davidectnia/InterleavedBoost-LIGH2TDRONE/IMAGES/immagini/plots/mccm_proto.png

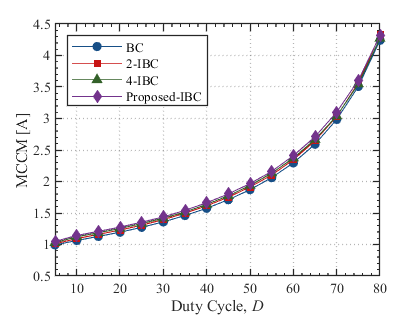
IMAGES/immagini/plots/mccm_proto.png
