davidectnia/InterleavedBoost-LIGH2TDRONE/SPICE/GateDriver/GateDriver_test.asc

C1: cap; 1µ
C2: cap; 1µ
R1: res; 22
R2: res; 20
U1: IR2110
U2: ST8L65N050DM9_V2K
V1: voltage; 3.3
V2: voltage; PULSE(0 3.3 0 10n 10n {D*Ts} {Ts})
V3: voltage; 12
V4: voltage; 44
Named nets: 0, Drain, Common, Gate, PWM
.lib ST8L65N050DM9_V2K.LIB
.temp 26.85
.tran 1m
.param D 0.73
.param fs 400k
.param Ts 1/fs
