davidectnia/InterleavedBoost-LIGH2TDRONE/SPICE/H100/test.asc

B1: bv; V=a*(-I(B1))**3+b*(-I(B1))**2+c*(-I(B1))+d
C1: cap; 100µ
R1: res; 1.5
Named nets: 0, +, -
.param a=-0.0026 b=0.3404 c=-1.87 dd=18.03
