davidectnia/InterleavedBoost-LIGH2TDRONE/SPICE/H100/test2.asc

B1: bv; V=a*(-I(B1))**3+b*(-I(B1))**2+c*(-I(B1))+d
B2: bv; V=a*(-I(B1))**3+b*(-I(B1))**2+c*(-I(B1))+d
B3: bv; V=a*(-I(B1))**3+b*(-I(B1))**2+c*(-I(B1))+d
C1: cap; 100µ
C2: cap; 1n
I1: current; 1
I2: current; 1
I3: current; 1
R1: res; 1.5
R2: res; 1.5
R3: res; 100m
Named nets: 0
.param a=-0.026 b=0.3404 c=-1.87 d=18.03
.dc I1 0 10 0.01
