davidectnia/InterleavedBoost-LIGH2TDRONE/SPICE/Capacitor Stack/capacitor_stack_input50V.asc

C1: cap; {C_CER1u}; Rser={ESR_CER1u} Lser={ESL_CER1u}
C2: cap; {C_CER220n}; Rser={ESR_CER220n} Lser={ESL_CER220n}
C3: cap; {C_CER1u}; Rser={ESR_CER1u} Lser={ESL_CER1u}
C4: cap; {C_CER220n}; Rser={ESR_CER220n} Lser={ESL_CER220n}
C5: cap; {C_CER10u}; Rser={ESR_CER10u} Lser={ESL_CER10u}
C6: cap; {C_CER10n}; Rser={ESR_CER10n} Lser={ESL_CER10n}
C7: cap; {C_CER100n}; Rser={ESR_CER100n} Lser={ESL_CER100n}
C8: cap; {C_CER1u}; Rser={ESR_CER1u} Lser={ESL_CER1u}
C9: cap; {C_CER10u}; Rser={ESR_CER10u} Lser={ESL_CER10u}
C10: cap; {C_CER220n}; Rser={ESR_CER220n} Lser={ESL_CER220n}
C11: cap; {C_CER2u2}; Rser={ESR_CER2u2} Lser={ESL_CER2u2}
C12: cap; {C_CER10u}; Rser={ESR_CER10u} Lser={ESL_CER10u}
C13: cap; {C_CER4u7}; Rser={ESR_CER4u7} Lser={ESL_CER4u7}
I1: current; ""; AC 1
I2: current; ""; AC 1
I3: current; ""; AC 1
I4: current; ""; AC 1
I5: current; ""; AC 1
I6: current; ""; AC 1
I7: current; ""; AC 1
Named nets: 0, 10n, 1u, 220N, 100N, 10u
.ac dec 100 100k 100Meg
.param C_CER1u 1u
.param ESR_CER1u 6.2m
.param ESL_CER1u 470p
.param C_CER100n 100n
.param ESR_CER100n 25m
.param ESL_CER100n 3n
.param C_CER220n 220n
.param ESR_CER220n 25m
.param ESL_CER220n 3n
.param C_CER10n 10n
.param ESR_CER10n 6.5m
.param ESL_CER10n 11.2n
.param C_CER10u 10u
.param ESR_CER10u 3m
.param ESL_CER10u 1n
.param C_CER2u2 2.2u
.param ESR_CER2u2 3m
.param ESL_CER2u2 1n
.param C_CER4u7 4.7u
.param ESR_CER4u7 3m
.param ESL_CER4u7 1n
