davidectnia/InterleavedBoost-LIGH2TDRONE/SPICE/Capacitor Stack/capacitor_stack_output100V.asc

C1: cap; {C_CER1}; Rser={ESR_CER1} Lser={ESL_CER1}
C2: cap; {C_CER2}; Rser={ESR_CER2} Lser={ESL_CER2}
C3: cap; {C_CER_470n}; Rser={ESR_CER2} Lser={ESL_CER2}
C4: cap; {C_EL}; Rser={ESR_C_EL} Lser={ESL_C_EL}
C5: cap; {C_EL}; Rser={ESR_C_EL} Lser={ESL_C_EL}
C6: cap; {C_EL}; Rser={ESR_C_EL} Lser={ESL_C_EL}
C7: cap; {C_EL}; Rser={ESR_C_EL} Lser={ESL_C_EL}
C8: cap; {C_CER1}; Rser={ESR_CER1} Lser={ESL_CER1}
C9: cap; {C_CER3}; Rser={ESR_CER3} Lser={ESL_CER3}
C10: cap; {C_CER2}; Rser={ESR_CER2} Lser={ESL_CER2}
C11: cap; {C_EL_22u}; Rser={ESR_C_EL} Lser={ESL_C_EL}
C12: cap; {C_EL_22u}; Rser={ESR_C_EL} Lser={ESL_C_EL}
C13: cap; {C_CER_100n}; Rser={ESR_CER1} Lser={ESL_CER1}
C14: cap; {C_EL_22u}; Rser={ESR_C_EL} Lser={ESL_C_EL}
C15: cap; {C_CER_1u}; Rser={ESR_CER3} Lser={ESL_CER3}
C16: cap; {C_CER1}; Rser={ESR_CER1} Lser={ESL_CER1}
C17: cap; {C_EL}; Rser={ESR_C_EL} Lser={ESL_C_EL}
C18: cap; {C_CER1}; Rser={ESR_CER1} Lser={ESL_CER1}
C19: cap; {C_EL}; Rser={ESR_C_EL} Lser={ESL_C_EL}
C20: cap; {C_EL}; Rser={ESR_C_EL} Lser={ESL_C_EL}
C21: cap; {C_CER3}; Rser={ESR_CER3} Lser={ESL_CER3}
C22: cap; {C_CER3}; Rser={ESR_CER3} Lser={ESL_CER3}
C23: cap; {C_CER1}; Rser={ESR_CER1} Lser={ESL_CER1}
I1: current; 0; AC 1
I2: current; 0; AC 1
I3: current; 0; AC 1
I4: current; 0; AC 1
I5: current; 0; AC 1
I6: current; 0; AC 1
I7: current; 0; AC 1
Named nets: 0
.param C_EL 22u
.param ESR_C_EL 40m
.param ESL_C_EL 5n
.param C_CER1 100n
.param ESR_CER1 30m
.param ESL_CER1 500p
.param C_CER3 1u
.param ESR_CER3 12m
.param ESL_CER3 970p
.param C_CER2 470n
.param ESR_CER2 30m
.param ESL_CER2 550p
Ceramic Capacitors
Electrolythic Capacitors
.ac dec 100 100k 100Meg
