davidectnia/InterleavedBoost-LIGH2TDRONE/SPICE/Capacitor Stack/stack_cap_input.asc

C3: cap; {C_CER1}; Rser={ESR_CER1} Lser={ESL_CER1}
C5: cap; {C_CER3}; Rser={ESR_CER3} Lser={ESL_CER3}
Named nets: C+, C-
.param C_CER1 100n
.param ESR_CER1 22.1m
.param ESL_CER1 253.3p
.param C_CER3 1u
.param ESR_CER3 6.2m
.param ESL_CER3 54.5p
50V Voltage Rating Ceramic Capacitors
