davidectnia/InterleavedBoost-LIGH2TDRONE/SPICE/Elementary/boostideal.asc

C1: cap; {Cin}; Rser=10m
C2: cap; {Co}; Rser=200m
D1: diode; Ideal_D
L1: ind; {Ld}
R1: res; {RL}
S1: sw; Ideal_SW
V1: voltage; PULSE(0 10 0 10n 10n {D*Ts} {Ts})
V2: voltage; {V_in}; Rser=10m
Named nets: 0, out, in
.param Ld=27u
.param Co=47u
.param RL 20
.param Dmin 0.2105
.param Dmax 0.6053
.param Vin_min 150
.param Vin_max 300
.param fs 400k
.tran 0 {Tend} 0 10n
.param V_in=12
.param D=1-{V_in}/{Vout}
.param Cin  1u
.param Ts=1/fs Tstart={Tend}-Nperiods*Ts Tend=5m
.model Ideal_SW SW(Ron = 10m)
.model Ideal_D D(Ron = 1m, Vfwd=0)
.meas Id_avg AVG I(D1) FROM Tstart TO Tend
.meas Id_rms RMS I(D1) FROM Tstart TO Tend
.meas IL_avg AVG I(L1) FROM Tstart TO Tend
.meas IL_rms RMS I(L1) FROM Tstart TO Tend
.meas Isw_avg AVG I(S1) FROM Tstart TO Tend
.meas Isw_rms RMS I(S1) FROM Tstart TO Tend
.meas Ico_avg AVG I(C2) FROM Tstart TO Tend
.meas Ico_rms RMS I(C2) FROM Tstart TO Tend
.meas Icin_avg AVG I(C1) FROM Tstart TO Tend
.meas Icin_rms RMS I(C1) FROM Tstart TO Tend
;step param V_in list 10 12 18
.param Vout 44.4
.param Nperiods 50
.step param D 0 1 0.05
.meas V_out AVG V(out) FROM Tstart TO Tend
.meas M_ccm param V_out/V_in
