davidectnia/InterleavedBoost-LIGH2TDRONE/SPICE/GateDriver/GateDriver.asc

C1: cap; 1µ
C2: cap; 1µ
U1: IR2110
V1: voltage; 3.3; Rser=1m
V3: voltage; 12; Rser=1m
Named nets: 0, GateLOW-, PWM, GateLOW+
