davidectnia/InterleavedBoost-LIGH2TDRONE/SPICE/Housekeeping&Sensing/currentsensenew_INA.asc

C1: cap; {C2}
R1: res; {wc(R1, tol, 0)}
R2: res; {wc(R2, tol, 1)}
U1: INA326
V1: voltage; 3.3
V2: voltage; 2.5; AC 1
V4: voltage; 2.5
Named nets: 0, Vsup, VH, Vout
.func wc(nom,tol,index) if(run==numruns,nom,if(binary(run,index),nom*(1+tol),nom*(1-tol)))
.func binary(run,index) floor(run/(2**index))-2*floor(run/(2**(index+1)))
.param tol 0.1
.param Rval1 1.2k
.param Rval2 3.9k
.param Rhall1 12k
.param Rhallf 68k
.param Rhall2 12k
.param Rhallg 68k
.param tol 0.05
.param Rval1 2.4k
.param Rval2 7.5k
.param Rhall1 2.2k
.param Rhallf 12k
.param Rhall2 2.2k
.param Rhallg 12k
.param tol 0.01
.param Rval1 3.24k
.param Rval2 10.1k
.param Rhall1 2.49k
.param Rhallf 13.7k
.param Rhall2 2.49k
.param Rhallg 13.7k
.param tol 0.001
.param Rval1 4.22k
.param Rval2 13.2k
.param Rhall1 11.1k
.param Rhallf 60.4k
.param Rhall2 11.1k
.param Rhallg 60.4k
E12 10%
E24 5%
E96 1%
E192 0.1%
.step param run 0 4 1
.param numruns=4
.dc V2 2.47 3.21 0.01
.include INA326.LIB
.param tol 0.01
.param R1 80k
.param R2 200k
.param C2 500p
