davidectnia/InterleavedBoost-LIGH2TDRONE/SPICE/Real/boost_load.asc

C1: cap; {C_EL}; Rser={ESR_C_EL} Lser={ESL_C_EL}
C2: cap; {C_EL}; Rser={ESR_C_EL} Lser={ESL_C_EL}
C3: cap; {C_EL}; Rser={ESR_C_EL} Lser={ESL_C_EL}
C4: cap; {C_CER10u}; Rser={ESR_CER10u} Lser={ESL_CER10u}
C5: cap; {C_CER1u}; Rser={ESR_CER1u} Lser={ESL_CER1u}
C6: cap; {C_CER220n}; Rser={ESR_CER220n} Lser={ESL_CER220n}
C7: cap; {C_CER220n}; Rser={ESR_CER220n} Lser={ESL_CER220n}
C8: cap; {C_CER1}; Rser={ESR_CER1} Lser={ESL_CER1}
C9: cap; {C_CER1}; Rser={ESR_CER1} Lser={ESL_CER1}
C10: cap; {C_CER3}; Rser={ESR_CER3} Lser={ESL_CER3}
D1: diode; V60D100C
L1: ind; {Ld}; Rser={ESR_L} Cpar={Cp_L}
M1: nmos; BSC110N15NS5SC_L1
R1: res; {RL}
R2: res; 5
V1: voltage; PULSE(0 10 0 2n 2n {D*Ts} {Ts}); Rser=10
Vin1: voltage; {V_in}; Rser=0.5
Named nets: 0, out, in, Vsw1
.param Ld=27u
;param RL 30
.tran 0 {Tend} 0 100n
.param D=0.73
.param Ts=1/fs Tstart={Tend}-Nperiods*Ts Tend=2m
Model Definition of diode
.step param D 0 1 0.1
.param V_in 12
.param Vin_min 10
.param Vin_nom 12
.param Vin_max 18
.param Vo_min 38.4
.param Vo_nom 44.4
.param Vo_max 50.4
.param fs 400k
.param V_stack 38.4
.param ESR_stack 100m
Passive Components
Converter Parameters
.meas Id_avg AVG I(D1) FROM Tstart TO Tend
.meas Id_rms RMS I(D1) FROM Tstart TO Tend
.meas Id_max_peak MAX I(D1) FROM Tstart TO Tend
.meas Id_max_surge MAX I(D1) FROM 0 TO Tend
.meas Vd_max_peak MAX (V(out)-V(Vsw1)) FROM Tstart TO Tend
.meas Vd_max_surge MAX (V(out)-V(Vsw1)) FROM 0 TO Tend
Absolute Maximum Ratings
Diode
.meas IL_avg AVG I(L1) FROM Tstart TO Tend
.meas IL_rms RMS I(L1) FROM Tstart TO Tend
Inductor
.meas Isw_avg AVG Ix(M1:D) FROM Tstart TO Tend
.meas Isw_rms RMS Ix(M1:D) FROM Tstart TO Tend
.meas Vsw_max_peak MAX V(Vsw1) FROM Tstart TO Tend
.meas Vsw_max_surge MAX V(Vsw1) FROM 0 TO Tend
MOSFET
.meas Ico_avg AVG I(C2) FROM Tstart TO Tend
.meas Ico_rms RMS I(C2) FROM Tstart TO Tend
.meas Ico2_rms RMS I(C3) FROM Tstart TO Tend
.meas Ico3_rms RMS I(C4) FROM Tstart TO Tend
.meas Vco_max_peak MAX V(out) FROM Tstart TO Tend
.meas Vco_max_surge MAX V(out) FROM 0 TO Tend
.meas Icin_avg AVG I(C1) FROM Tstart TO Tend
.meas Icin_rms RMS I(C1) FROM Tstart TO Tend
Input/Output Capacitors
Duty Cycle
MEAS directives
Vout Ripple
.meas Vomax MAX V(out) FROM Tstart TO Tend
.meas Vomin MIN V(out) FROM Tstart TO Tend
.meas Vo_Ripple PARAM (Vomax-Vomin)
Output/Input Current Ripple
.meas Iomax MAX I(R1) FROM Tstart TO Tend
.meas Iomin MIN I(R1) FROM Tstart TO Tend
.meas Io_Ripple PARAM (Iomax-Iomin)
.meas Iinmax MAX -I(Vin1) FROM Tstart TO Tend
.meas Iinmin MIN -I(Vin1) FROM Tstart TO Tend
.meas Iin_Ripple PARAM (Iinmax-Iinmin)
.meas I_in AVG -I(Vin1) FROM Tstart TO Tend
.meas I_out AVG I(R1) FROM Tstart TO Tend
.meas V_out AVG V(out) FROM Tstart TO Tend
.meas TRAN Pin PARAM='I_in*V_in'
.meas TRAN Pout PARAM='V_out*I_out'
.meas TRAN eta PARAM='Pout/Pin'
Converter Efficiency
Converter Conversion Ratio
.meas M_ccm param V_out/V_in
Simulation Directives
Inductor Parasitics
.param Nperiods 20
.model Ideal_D D(Ron = 1m, Vfwd=0)
Ceramic Capacitors
.param C_EL 22u
.param ESR_C_EL 40m
.param ESL_C_EL 5n
Electrolythic Capacitors
Input Capacitors
.param C_CER10u 10u
.param ESR_CER10u 3m
.param ESL_CER10u 1n
.param C_CER1u 1u
.param ESR_CER1u 6.2m
.param ESL_CER1u 470p
.param C_CER220n 220n
.param ESR_CER220n 25m
.param ESL_CER220n 3n
.param C_CER10n 10n
.param ESR_CER10n 6.5m
.param ESL_CER10n 11.2n
.param C_CER1 100n
.param ESR_CER1 30m
.param ESL_CER1 500p
Output Capacitors
.param C_CER2 470n
.param ESR_CER2 30m
.param ESL_CER2 550p
.param C_CER3 1u
.param ESR_CER3 12m
.param ESL_CER3 970p
.param SRF 7Meg
.param ESR_L 1.5m
.param Cp_L = 1/((2*pi*SRF)**2 * Ld)
.options abstol=1e-6 vntol=1e-4 method=trap
Modified Simulation Parameters
Selected switch SPICE model
Ideal Diode
.param Vo_boost Vo_nom
;step param Vo_boost Vo_min Vo_max 5
;param D=1-{V_in}/{Vo_boost}
;param RL= pow(Vo_boost, 2) / 96
.param RL=20
.MODEL V60D100C D
 
+ IS=1.4600E-6
+ N=1.0217
+ RS=7.6009E-3
+ IKF=4.0820
+ CJO=3.4371E-9
+ M=1.0126
+ VJ=3.230
+ ISR=812.71E-9
+ NR=14.985
+ BV=150.16
+ IBV=2.1608
+ TT=31.067E-12
Real Diode
.inc OptiMOS5_150V_LTSpice.lib
