davidectnia/InterleavedBoost-LIGH2TDRONE/STM32/IBC_Tesi_4phases_CL_fixedpoint/IBC_Tesi_4phases_CL.ioc

Mcu.UserName=STM32F334R8Tx
PA10.GPIO_Label=CHB1 PWM2
PA10.Signal=HRTIM1_CHB1
PA2.Signal=USART2_TX
PA3.Signal=USART2_RX
PA4.Signal=ADC2_IN1
PA5.Signal=GPIO_Output
PA6.Signal=ADC2_IN3
PA7.Signal=ADC2_IN4
PA8.GPIO_Label=CHA1 PWM1
PA8.Signal=HRTIM1_CHA1
PB1.Signal=ADC1_IN12
PB12.GPIO_Label=CHC1 PWM3
PB12.Signal=HRTIM1_CHC1
PB14.GPIO_Label=CHD1 PWM4
PB14.Signal=HRTIM1_CHD1
PB15.Signal=ADC2_IN15
PC0.Signal=ADCx_IN6
PC1.Signal=ADCx_IN7
PC2.Signal=ADCx_IN8
PC3.Signal=ADCx_IN9
PC4.Signal=ADC2_IN5
PC5.Signal=ADC2_IN11
