davidectnia/InterleavedBoost-LIGH2TDRONE/STM32/IBC_Tesi_4phases/Core/Src/main.c

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
/* Includes ------------------------------------------------------------------*/
#include "main.h"

/* USER CODE BEGIN Includes */
#include <stdlib.h>
#include <string.h>
#include <stdio.h>
/* USER CODE END Includes */

ADC_HandleTypeDef hadc1;
ADC_HandleTypeDef hadc2;
DMA_HandleTypeDef hdma_adc1;
DMA_HandleTypeDef hdma_adc2;

HRTIM_HandleTypeDef hhrtim1;

UART_HandleTypeDef huart2;

/* USER CODE BEGIN PV */


/*vairabili per UART*/
uint8_t uart_rx_byte;         /* Singolo carattere ricevuto */
char    uart_rx_buffer[16];   /* Stringa accumulata fino alla pressione di INVIO */
uint8_t uart_rx_index = 0;

/* Variabili modificabili in runtime (Open Loop) */
volatile uint8_t  NumActivePhases = 4;              /* Valori ammessi: 1, 2, 3, 4 */
volatile uint8_t  PrevActivePhases = 0;             /* Usata per rilevare il cambio fase */
volatile float    TargetDutyPercent = 25.0f;        /* Duty cycle impostabile (es. 0.0 - 80.0 %) */
volatile uint32_t CurrentDutyTicks = DUTY_CYCLE_INIT;

volatile uint16_t PhaseCurrents_ADC2[4]; 		/*Accessed by DMA, PH1->PH4, PA4-PA6-PA7-PC4*/
volatile uint16_t PhaseVoltages_ADC1[4];		/*Accessed by DMA, PH1->PH4, PC0-PC1-PC2-PC3*/

/* Injected Channels No DMA, triggered by software */

volatile uint16_t OutputCurrent_ADC1 = 0; /* PB1 (ADC1_IN12) */
volatile uint16_t OutputVoltage_ADC2 = 0; /* PC5 (ADC2_IN11) */
volatile uint16_t Temperature_ADC2   = 0; /* PB15 (ADC2_IN15) */
/* USER CODE END PV */

void SystemClock_Config(void);
static void MX_GPIO_Init(void);
static void MX_DMA_Init(void);
static void MX_HRTIM1_Init(void);
static void MX_ADC1_Init(void);
static void MX_ADC2_Init(void);
static void MX_USART2_UART_Init(void);
/* USER CODE BEGIN PFP */
static void Update_Boost_Parameters(void);
static void HRTIM_Config(void);
/* USER CODE END PFP */

/**
  * @brief  The application entry point.
  * @retval int
  */
int main(void)
{

  /* MCU Configuration--------------------------------------------------------*/

  /* Reset of all peripherals, Initializes the Flash interface and the Systick. */
  HAL_Init();

  /* USER CODE BEGIN Init */
  /* Initialize User_Button on STM32F3348-DISCO */

  /* Initialize ADC to be triggered by the HRTIMER */
  //ADC_Config();


  /* USER CODE END Init */

  /* Configure the system clock */
  SystemClock_Config();

  /* Initialize all configured peripherals */
  MX_GPIO_Init();
  MX_DMA_Init();
  //MX_HRTIM1_Init();
  MX_ADC1_Init();
  MX_ADC2_Init();
  MX_USART2_UART_Init();
  /* USER CODE BEGIN 2 */

  /* 1. Calibrazione hardware di ADC1 e ADC2 in Single-Ended (come in main.c) */
  if (HAL_ADCEx_Calibration_Start(&hadc1, ADC_SINGLE_ENDED) != HAL_OK)
  {
	  Error_Handler();
  }
  if (HAL_ADCEx_Calibration_Start(&hadc2, ADC_SINGLE_ENDED) != HAL_OK)
  {
	  Error_Handler();
  }
  /* 2. Avvia il DMA in modalità Circular per i 4 canali Regular di ADC1 e ADC2 */
    /* Da questo momento gli ADC aspettano in automatico i trigger HRTIM_ADCTRIGGER_1 */
  if (HAL_ADC_Start_DMA(&hadc1, (uint32_t *)PhaseVoltages_ADC1, 4) != HAL_OK)
  {
	  Error_Handler();
  }
  if (HAL_ADC_Start_DMA(&hadc2, (uint32_t *)PhaseCurrents_ADC2, 4) != HAL_OK)
  {
	  Error_Handler();
  }
  /* DISABILITA GLI INTERRUPT DEL DMA: il DMA continua a copiare i dati in RAM in
       modalità Circular a 400 kHz, ma lascia libera al 100% la CPU e la UART! */


  __HAL_DMA_DISABLE_IT(&hdma_adc1, DMA_IT_HT | DMA_IT_TC | DMA_IT_TE);
  __HAL_DMA_DISABLE_IT(&hdma_adc2, DMA_IT_HT | DMA_IT_TC | DMA_IT_TE);
  HAL_NVIC_DisableIRQ(DMA1_Channel1_IRQn);
  HAL_NVIC_DisableIRQ(DMA1_Channel2_IRQn);

  /* 3. Configura l'HRTIM1 e collega i pin fisici PA8, PA10, PB12, PB14 */
  HRTIM_Config();
  HAL_HRTIM_MspPostInit(&hhrtim1);
  /* Enable HRTIM's outputs TA2, TB1, TC2, TD1, TD2 */
  HAL_HRTIM_WaveformOutputStart(&hhrtim1, HRTIM_OUTPUT_TA1 | HRTIM_OUTPUT_TB1 | HRTIM_OUTPUT_TC1 | HRTIM_OUTPUT_TD1);
  /* Start HRTIM's TIMER A, B, C, D */
  HAL_HRTIM_WaveformCountStart(&hhrtim1, HRTIM_TIMERID_MASTER | HRTIM_TIMERID_TIMER_A | HRTIM_TIMERID_TIMER_B | HRTIM_TIMERID_TIMER_C | HRTIM_TIMERID_TIMER_D);

  char welcome_msg[] = "\r\n--- BOOST 4 FASI PRONTO ---\r\nDigita Duty (1-100) + INVIO (oppure P1..P4 per le fasi):\r\n";
  /* USER CODE END 2 */

  /* Infinite loop */
  /* USER CODE BEGIN WHILE */
  while (1)
  {
	  /* Aggiorna numero fasi e duty cycle da Live Expressions */
	  Update_Boost_Parameters();

	  HAL_ADCEx_InjectedStart(&hadc1);
	  HAL_ADCEx_InjectedStart(&hadc2);

	      /* 3. Leggi i risultati dai registri dedicati JDR1 e JDR2 */
	  OutputCurrent_ADC1 = HAL_ADCEx_InjectedGetValue(&hadc1, ADC_INJECTED_RANK_1);
	  OutputVoltage_ADC2 = HAL_ADCEx_InjectedGetValue(&hadc2, ADC_INJECTED_RANK_1);
	  Temperature_ADC2   = HAL_ADCEx_InjectedGetValue(&hadc2, ADC_INJECTED_RANK_2);

	  /* Avvia l'ascolto della tastiera su USART2 (1 carattere alla volta in Interrupt) */
	  HAL_UART_Receive_IT(&huart2, &uart_rx_byte, 1);

	  HAL_Delay(10); /* Controlla modifiche ogni 10 ms */
    /* USER CODE END WHILE */

    /* USER CODE BEGIN 3 */
  }
  /* USER CODE END 3 */
}

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
/* USER CODE BEGIN 4 */
static void HRTIM_Config(void)
{
  HRTIM_TimeBaseCfgTypeDef timebase_config = {0};
  HRTIM_TimerCfgTypeDef timer_config = {0};
  HRTIM_OutputCfgTypeDef output_config = {0};
  HRTIM_CompareCfgTypeDef compare_config = {0};
  HRTIM_ADCTriggerCfgTypeDef adc_trigger_config = {0};
  HRTIM_FaultCfgTypeDef fault_config = {0};
  HRTIM_BurstModeCfgTypeDef burst_config = {0};

  /* ----------------------------*/
  /* HRTIM Global initialization */
  /* ----------------------------*/
  hhrtim1.Instance = HRTIM1;
  hhrtim1.Init.HRTIMInterruptResquests = HRTIM_IT_NONE;
  hhrtim1.Init.SyncOptions = HRTIM_SYNCOPTION_NONE;

  if (HAL_HRTIM_Init(&hhrtim1) != HAL_OK)
  {
    Error_Handler();
  }

  /* HRTIM DLL calibration: periodic calibration, set period to 14 us */
  HAL_HRTIM_DLLCalibrationStart(&hhrtim1, HRTIM_CALIBRATIONRATE_14);
  if (HAL_HRTIM_PollForDLLCalibration(&hhrtim1, DLL_CALIBRATIONTIMEOUT) != HAL_OK)
  {
    Error_Handler();
  }

  /* ---------------------------------------------------------------- */
  /* 1. MASTER TIMER TIMEBASE (Quello che era stato sovrascritto!)    */
  /* ---------------------------------------------------------------- */
  timebase_config.Period = MULTIPHASE_PERIOD;
  timebase_config.RepetitionCounter = REPETITON_RATE;
  timebase_config.PrescalerRatio = HRTIM_PRESCALERRATIO_MUL32;
  timebase_config.Mode = HRTIM_MODE_CONTINUOUS;
  if (HAL_HRTIM_TimeBaseConfig(&hhrtim1, HRTIM_TIMERINDEX_MASTER, &timebase_config) != HAL_OK)
  {
    Error_Handler();
  }

  /* ---------------------------------------------------------- */
  /* 2. MASTER TIMER WAVEFORM CONFIG                            */
  /* ---------------------------------------------------------- */
  timer_config.DMARequests = HRTIM_TIM_DMA_NONE;
  timer_config.DMASrcAddress = 0x0;
  timer_config.DMADstAddress = 0x0;
  timer_config.DMASize = 0x0;
  timer_config.HalfModeEnable = HRTIM_HALFMODE_DISABLED;
  timer_config.StartOnSync = HRTIM_SYNCSTART_DISABLED;
  timer_config.ResetOnSync = HRTIM_SYNCRESET_DISABLED;
  timer_config.DACSynchro = HRTIM_DACSYNC_NONE;
  timer_config.PreloadEnable = HRTIM_PRELOAD_ENABLED;
  timer_config.UpdateGating = HRTIM_UPDATEGATING_INDEPENDENT;
  timer_config.BurstMode = HRTIM_TIMERBURSTMODE_MAINTAINCLOCK;
  timer_config.RepetitionUpdate = HRTIM_UPDATEONREPETITION_ENABLED;
  timer_config.InterruptRequests = HRTIM_MASTER_IT_NONE; /* NONE per Open Loop */
  HAL_HRTIM_WaveformTimerConfig(&hhrtim1, HRTIM_TIMERINDEX_MASTER, &timer_config);

  /* -------------------------------------------------------------- */
  /* 3. TIMERA, TIMERB, TIMERC, TIMERD TIMEBASE                     */
  /* -------------------------------------------------------------- */
  timebase_config.Period = MULTIPHASE_PERIOD - 1 - ADC_CONVERSION_TIME;
  timebase_config.RepetitionCounter = REPETITON_RATE;
  timebase_config.PrescalerRatio = HRTIM_PRESCALERRATIO_MUL32;
  timebase_config.Mode = HRTIM_MODE_SINGLESHOT_RETRIGGERABLE;
  HAL_HRTIM_TimeBaseConfig(&hhrtim1, HRTIM_TIMERINDEX_TIMER_A, &timebase_config);
  HAL_HRTIM_TimeBaseConfig(&hhrtim1, HRTIM_TIMERINDEX_TIMER_B, &timebase_config);
  HAL_HRTIM_TimeBaseConfig(&hhrtim1, HRTIM_TIMERINDEX_TIMER_C, &timebase_config);
  HAL_HRTIM_TimeBaseConfig(&hhrtim1, HRTIM_TIMERINDEX_TIMER_D, &timebase_config);

  /* --------------------------------------------------------------------- */
  /* 4. TIMERA, TIMERB, TIMERC, TIMERD WAVEFORM CONFIG                     */
  /* --------------------------------------------------------------------- */
  timer_config.DMARequests = HRTIM_TIM_DMA_NONE;
  timer_config.DMASrcAddress = 0x0;
  timer_config.DMADstAddress = 0x0;
  timer_config.DMASize = 0x0;
  timer_config.HalfModeEnable = HRTIM_HALFMODE_DISABLED;
  timer_config.StartOnSync = HRTIM_SYNCSTART_DISABLED;
  timer_config.ResetOnSync = HRTIM_SYNCRESET_DISABLED;
  timer_config.DACSynchro = HRTIM_DACSYNC_NONE;
  timer_config.PreloadEnable = HRTIM_PRELOAD_ENABLED;
  timer_config.UpdateGating = HRTIM_UPDATEGATING_INDEPENDENT;
  timer_config.BurstMode = HRTIM_TIMERBURSTMODE_MAINTAINCLOCK;
  timer_config.RepetitionUpdate = HRTIM_UPDATEONREPETITION_DISABLED;
  timer_config.ResetUpdate = HRTIM_TIMUPDATEONRESET_DISABLED;
  timer_config.InterruptRequests = HRTIM_TIM_IT_NONE;
  timer_config.PushPull = HRTIM_TIMPUSHPULLMODE_DISABLED;
  timer_config.FaultEnable = HRTIM_TIMFAULTENABLE_NONE;
  timer_config.FaultLock = HRTIM_TIMFAULTLOCK_READWRITE;
  timer_config.DeadTimeInsertion = HRTIM_TIMDEADTIMEINSERTION_DISABLED;
  timer_config.DelayedProtectionMode = HRTIM_TIMER_A_B_C_DELAYEDPROTECTION_DISABLED;
  timer_config.UpdateTrigger = HRTIM_TIMUPDATETRIGGER_MASTER;

  timer_config.ResetTrigger = HRTIM_TIMRESETTRIGGER_MASTER_PER;
  HAL_HRTIM_WaveformTimerConfig(&hhrtim1, HRTIM_TIMERINDEX_TIMER_A, &timer_config);

  timer_config.ResetTrigger = HRTIM_TIMRESETTRIGGER_MASTER_CMP1;
  HAL_HRTIM_WaveformTimerConfig(&hhrtim1, HRTIM_TIMERINDEX_TIMER_B, &timer_config);

  timer_config.ResetTrigger = HRTIM_TIMRESETTRIGGER_MASTER_CMP2;
  HAL_HRTIM_WaveformTimerConfig(&hhrtim1, HRTIM_TIMERINDEX_TIMER_C, &timer_config);

  timer_config.DelayedProtectionMode = HRTIM_TIMER_D_E_DELAYEDPROTECTION_DISABLED;
  timer_config.ResetTrigger = HRTIM_TIMRESETTRIGGER_MASTER_CMP3;
  HAL_HRTIM_WaveformTimerConfig(&hhrtim1, HRTIM_TIMERINDEX_TIMER_D, &timer_config);

  /* -------------------------------------------- */
  /* 5. CONFIGURAZIONE USCITE: TA1, TB1, TC1, TD1 */
  /* -------------------------------------------- */
  output_config.Polarity = HRTIM_OUTPUTPOLARITY_HIGH;
  output_config.SetSource = HRTIM_OUTPUTSET_MASTERPER;
  output_config.ResetSource = HRTIM_OUTPUTRESET_TIMCMP1;
  output_config.IdleMode = HRTIM_OUTPUTIDLEMODE_IDLE;
  output_config.IdleLevel = HRTIM_OUTPUTIDLELEVEL_INACTIVE;
  output_config.FaultLevel = HRTIM_OUTPUTFAULTLEVEL_INACTIVE;
  output_config.ChopperModeEnable = HRTIM_OUTPUTCHOPPERMODE_DISABLED;
  output_config.BurstModeEntryDelayed = HRTIM_OUTPUTBURSTMODEENTRY_REGULAR;

  /* Fase 1: TA1 (PA8) */
  HAL_HRTIM_WaveformOutputConfig(&hhrtim1, HRTIM_TIMERINDEX_TIMER_A, HRTIM_OUTPUT_TA1, &output_config);

  /* Fase 2: TB1 (PA10) */
  output_config.SetSource = HRTIM_OUTPUTSET_MASTERCMP1;
  output_config.ResetSource = HRTIM_OUTPUTRESET_TIMCMP1;
  HAL_HRTIM_WaveformOutputConfig(&hhrtim1, HRTIM_TIMERINDEX_TIMER_B, HRTIM_OUTPUT_TB1, &output_config);

  /* Fase 3: TC1 (PB12) */
  output_config.SetSource = HRTIM_OUTPUTSET_MASTERCMP2;
  output_config.ResetSource = HRTIM_OUTPUTRESET_TIMCMP1;
  HAL_HRTIM_WaveformOutputConfig(&hhrtim1, HRTIM_TIMERINDEX_TIMER_C, HRTIM_OUTPUT_TC1, &output_config);

  /* Fase 4: TD1 (PB14) */
  output_config.SetSource = HRTIM_OUTPUTSET_MASTERCMP3;
  output_config.ResetSource = HRTIM_OUTPUTRESET_TIMCMP1;
  HAL_HRTIM_WaveformOutputConfig(&hhrtim1, HRTIM_TIMERINDEX_TIMER_D, HRTIM_OUTPUT_TD1, &output_config);

  /* ------------------------------------------------------------------- */
  /* 6. DUTY CYCLE (COMPAREUNIT_1) - Quello che era stato sovrascritto!  */
  /* ------------------------------------------------------------------- */
  compare_config.AutoDelayedMode = HRTIM_AUTODELAYEDMODE_REGULAR;
  compare_config.AutoDelayedTimeout = 0;
  compare_config.CompareValue = DUTY_CYCLE_INIT;

  HAL_HRTIM_WaveformCompareConfig(&hhrtim1, HRTIM_TIMERINDEX_TIMER_A, HRTIM_COMPAREUNIT_1, &compare_config);
  HAL_HRTIM_WaveformCompareConfig(&hhrtim1, HRTIM_TIMERINDEX_TIMER_B, HRTIM_COMPAREUNIT_1, &compare_config);
  HAL_HRTIM_WaveformCompareConfig(&hhrtim1, HRTIM_TIMERINDEX_TIMER_C, HRTIM_COMPAREUNIT_1, &compare_config);
  HAL_HRTIM_WaveformCompareConfig(&hhrtim1, HRTIM_TIMERINDEX_TIMER_D, HRTIM_COMPAREUNIT_1, &compare_config);

  /* ------------------------------------------------------------------- */
  /* 7. SFASAMENTI SUL MASTER TIMER (MCMP1, MCMP2, MCMP3)                */
  /* ------------------------------------------------------------------- */
  compare_config.CompareValue = PHASE_SHIFT_INIT;
  HAL_HRTIM_WaveformCompareConfig(&hhrtim1, HRTIM_TIMERINDEX_MASTER, HRTIM_COMPAREUNIT_1, &compare_config);

  compare_config.CompareValue = 2 * PHASE_SHIFT_INIT;
  HAL_HRTIM_WaveformCompareConfig(&hhrtim1, HRTIM_TIMERINDEX_MASTER, HRTIM_COMPAREUNIT_2, &compare_config);

  compare_config.CompareValue = 3 * PHASE_SHIFT_INIT;
  HAL_HRTIM_WaveformCompareConfig(&hhrtim1, HRTIM_TIMERINDEX_MASTER, HRTIM_COMPAREUNIT_3, &compare_config);

  /* -------------------------------------------------- */
  /* 8. BURST MODE CONFIG                               */
  /* -------------------------------------------------- */
  burst_config.ClockSource = HRTIM_BURSTMODECLOCKSOURCE_MASTER;
  burst_config.IdleDuration = BURST_IDLE;
  burst_config.Mode = HRTIM_BURSTMODE_CONTINOUS;
  burst_config.Period = BURST_PERIOD;
  burst_config.PreloadEnable = HRIM_BURSTMODEPRELOAD_ENABLED;
  burst_config.Prescaler = HRTIM_BURSTMODEPRESCALER_DIV1;
  burst_config.Trigger = HRTIM_BURSTMODETRIGGER_MASTER_RESET;
  HAL_HRTIM_BurstModeConfig(&hhrtim1, &burst_config);

  /* -------------------------------------------------------------- */
  /* 9. TRIGGER ADC A META' TON + DUMMY TRIGGERS                    */
  /* -------------------------------------------------------------- */
  compare_config.AutoDelayedMode = HRTIM_AUTODELAYEDMODE_REGULAR;
  compare_config.AutoDelayedTimeout = 0;
  compare_config.CompareValue = DUTY_CYCLE_INIT / 2;

  HAL_HRTIM_WaveformCompareConfig(&hhrtim1, HRTIM_TIMERINDEX_TIMER_A, HRTIM_COMPAREUNIT_2, &compare_config);
  HAL_HRTIM_WaveformCompareConfig(&hhrtim1, HRTIM_TIMERINDEX_TIMER_B, HRTIM_COMPAREUNIT_2, &compare_config);
  HAL_HRTIM_WaveformCompareConfig(&hhrtim1, HRTIM_TIMERINDEX_TIMER_C, HRTIM_COMPAREUNIT_2, &compare_config);
  HAL_HRTIM_WaveformCompareConfig(&hhrtim1, HRTIM_TIMERINDEX_TIMER_D, HRTIM_COMPAREUNIT_3, &compare_config);

  /* Dummy trigger per 3 fasi */
  compare_config.CompareValue = (MULTIPHASE_PERIOD / 3) - 1 - ADC_CONVERSION_TIME;
  HAL_HRTIM_WaveformCompareConfig(&hhrtim1, HRTIM_TIMERINDEX_TIMER_C, HRTIM_COMPAREUNIT_3, &compare_config);

  /* Dummy triggers per 2 fasi */
  compare_config.CompareValue = (MULTIPHASE_PERIOD / 2) - 1 - ADC_CONVERSION_TIME;
  HAL_HRTIM_WaveformCompareConfig(&hhrtim1, HRTIM_TIMERINDEX_TIMER_B, HRTIM_COMPAREUNIT_3, &compare_config);

  compare_config.CompareValue = (MULTIPHASE_PERIOD / 2) - 1 - (ADC_CONVERSION_TIME * 2);
  HAL_HRTIM_WaveformCompareConfig(&hhrtim1, HRTIM_TIMERINDEX_TIMER_B, HRTIM_COMPAREUNIT_4, &compare_config);

  /* Dummy triggers per 1 fase */
  compare_config.CompareValue = MULTIPHASE_PERIOD - 1 - (ADC_CONVERSION_TIME * 3);
  HAL_HRTIM_WaveformCompareConfig(&hhrtim1, HRTIM_TIMERINDEX_TIMER_A, HRTIM_COMPAREUNIT_3, &compare_config);

  compare_config.CompareValue = MULTIPHASE_PERIOD - 1 - (ADC_CONVERSION_TIME * 2);
  HAL_HRTIM_WaveformCompareConfig(&hhrtim1, HRTIM_TIMERINDEX_TIMER_A, HRTIM_COMPAREUNIT_4, &compare_config);

  adc_trigger_config.Trigger = HRTIM_ADCTRIGGEREVENT13_TIMERA_CMP2
                             | HRTIM_ADCTRIGGEREVENT13_TIMERB_CMP2
                             | HRTIM_ADCTRIGGEREVENT13_TIMERC_CMP2
                             | HRTIM_ADCTRIGGEREVENT13_TIMERD_CMP3;
  adc_trigger_config.UpdateSource = HRTIM_ADCTRIGGERUPDATE_MASTER;
  HAL_HRTIM_ADCTriggerConfig(&hhrtim1, HRTIM_ADCTRIGGER_1, &adc_trigger_config);

  /* ---------------------*/
  /* 10. FAULT CONFIG     */
  /* ---------------------*/
  fault_config.Filter = HRTIM_FAULTFILTER_NONE;
  fault_config.Lock = HRTIM_FAULTLOCK_READWRITE;
  fault_config.Polarity = HRTIM_FAULTPOLARITY_LOW;
  fault_config.Source = HRTIM_FAULTSOURCE_DIGITALINPUT;
  HAL_HRTIM_FaultConfig(&hhrtim1, HRTIM_FAULT_1, &fault_config);
}

static void Update_Boost_Parameters(void)
{
  HRTIM_ADCTriggerCfgTypeDef adc_trigger_config;
  float clamped_duty = TargetDutyPercent;

  /* 1. Sicurezza sul Duty Cycle (limita tra 2.0% e 80.0%) */
  if (clamped_duty < 2.0f)  clamped_duty = 2.0f;
  if (clamped_duty > 80.0f) clamped_duty = 80.0f;

  /* Converti da percentuale a ticks dell'HRTIM (su base 11520) */
  uint32_t new_duty_ticks = (uint32_t)((clamped_duty / 100.0f) * ((float)MULTIPHASE_PERIOD));

  /* Se il duty cycle è stato cambiato in Live Expressions, aggiorna i registri */
  if (new_duty_ticks != CurrentDutyTicks)
  {
    CurrentDutyTicks = new_duty_ticks;
    uint32_t half_ton_ticks = CurrentDutyTicks / 2; /* Nuovo punto a 50% di Ton per l'ADC */

    /* Aggiorna Duty Cycle (CMP1) su tutte e 4 le fasi */
    __HAL_HRTIM_SETCOMPARE(&hhrtim1, HRTIM_TIMERINDEX_TIMER_A, HRTIM_COMPAREUNIT_1, CurrentDutyTicks);
    __HAL_HRTIM_SETCOMPARE(&hhrtim1, HRTIM_TIMERINDEX_TIMER_B, HRTIM_COMPAREUNIT_1, CurrentDutyTicks);
    __HAL_HRTIM_SETCOMPARE(&hhrtim1, HRTIM_TIMERINDEX_TIMER_C, HRTIM_COMPAREUNIT_1, CurrentDutyTicks);
    __HAL_HRTIM_SETCOMPARE(&hhrtim1, HRTIM_TIMERINDEX_TIMER_D, HRTIM_COMPAREUNIT_1, CurrentDutyTicks);

    /* Aggiorna l'istante di campionamento ADC per restare sempre a metà Ton */
    __HAL_HRTIM_SETCOMPARE(&hhrtim1, HRTIM_TIMERINDEX_TIMER_A, HRTIM_COMPAREUNIT_2, half_ton_ticks);
    __HAL_HRTIM_SETCOMPARE(&hhrtim1, HRTIM_TIMERINDEX_TIMER_B, HRTIM_COMPAREUNIT_2, half_ton_ticks);
    __HAL_HRTIM_SETCOMPARE(&hhrtim1, HRTIM_TIMERINDEX_TIMER_C, HRTIM_COMPAREUNIT_2, half_ton_ticks);
    __HAL_HRTIM_SETCOMPARE(&hhrtim1, HRTIM_TIMERINDEX_TIMER_D, HRTIM_COMPAREUNIT_3, half_ton_ticks);
  }

  /* 2. Gestione cambio numero di fasi (1, 2, 3 o 4) */
  if (NumActivePhases != PrevActivePhases)
  {
    adc_trigger_config.UpdateSource = HRTIM_ADCTRIGGERUPDATE_MASTER;

    switch (NumActivePhases)
    {
      case 1: /* 1 FASE ATTIVA: Solo PH1 (TA1) */
        /* Spegni PH2, PH3, PH4 e mantieni accesa PH1 */
        HAL_HRTIM_WaveformOutputStop(&hhrtim1, HRTIM_OUTPUT_TB1 | HRTIM_OUTPUT_TC1 | HRTIM_OUTPUT_TD1);
        HAL_HRTIM_WaveformOutputStart(&hhrtim1, HRTIM_OUTPUT_TA1);

        /* Trigger ADC: 1 reale (TA_CMP2) + 3 dummy (TA_CMP3, TA_CMP4, TA_PER) */
        adc_trigger_config.Trigger = HRTIM_ADCTRIGGEREVENT13_TIMERA_CMP2
                                   | HRTIM_ADCTRIGGEREVENT13_TIMERA_CMP3
                                   | HRTIM_ADCTRIGGEREVENT13_TIMERA_CMP4
                                   | HRTIM_ADCTRIGGEREVENT13_TIMERA_PERIOD;
        HAL_HRTIM_ADCTriggerConfig(&hhrtim1, HRTIM_ADCTRIGGER_1, &adc_trigger_config);
        PrevActivePhases = 1;
        break;

      case 2: /* 2 FASI ATTIVE: PH1 e PH2 sfasate di 180° (MULTIPHASE_PERIOD / 2) */
        /* Sfasamento PH2 a 180 gradi */
        __HAL_HRTIM_SETCOMPARE(&hhrtim1, HRTIM_TIMERINDEX_MASTER, HRTIM_COMPAREUNIT_1, (MULTIPHASE_PERIOD / 2));

        /* Spegni PH3, PH4 e abilita PH1, PH2 */
        HAL_HRTIM_WaveformOutputStop(&hhrtim1, HRTIM_OUTPUT_TC1 | HRTIM_OUTPUT_TD1);
        HAL_HRTIM_WaveformOutputStart(&hhrtim1, HRTIM_OUTPUT_TA1 | HRTIM_OUTPUT_TB1);

        /* Trigger ADC: 2 reali (TA_CMP2, TB_CMP2) + 2 dummy (TB_CMP3, TB_CMP4) */
        adc_trigger_config.Trigger = HRTIM_ADCTRIGGEREVENT13_TIMERA_CMP2
                                   | HRTIM_ADCTRIGGEREVENT13_TIMERB_CMP2
                                   | HRTIM_ADCTRIGGEREVENT13_TIMERB_CMP3
                                   | HRTIM_ADCTRIGGEREVENT13_TIMERB_CMP4;
        HAL_HRTIM_ADCTriggerConfig(&hhrtim1, HRTIM_ADCTRIGGER_1, &adc_trigger_config);
        PrevActivePhases = 2;
        break;

      case 3: /* 3 FASI ATTIVE: PH1, PH2, PH3 sfasate di 120° (MULTIPHASE_PERIOD / 3) */
        /* Sfasamento PH2 a 120° e PH3 a 240° */
        __HAL_HRTIM_SETCOMPARE(&hhrtim1, HRTIM_TIMERINDEX_MASTER, HRTIM_COMPAREUNIT_1, (MULTIPHASE_PERIOD / 3));
        __HAL_HRTIM_SETCOMPARE(&hhrtim1, HRTIM_TIMERINDEX_MASTER, HRTIM_COMPAREUNIT_2, 2 * (MULTIPHASE_PERIOD / 3));

        /* Spegni PH4 e abilita PH1, PH2, PH3 */
        HAL_HRTIM_WaveformOutputStop(&hhrtim1, HRTIM_OUTPUT_TD1);
        HAL_HRTIM_WaveformOutputStart(&hhrtim1, HRTIM_OUTPUT_TA1 | HRTIM_OUTPUT_TB1 | HRTIM_OUTPUT_TC1);

        /* Trigger ADC: 3 reali (TA_CMP2, TB_CMP2, TC_CMP2) + 1 dummy (TC_CMP3) */
        adc_trigger_config.Trigger = HRTIM_ADCTRIGGEREVENT13_TIMERA_CMP2
                                   | HRTIM_ADCTRIGGEREVENT13_TIMERB_CMP2
                                   | HRTIM_ADCTRIGGEREVENT13_TIMERC_CMP2
                                   | HRTIM_ADCTRIGGEREVENT13_TIMERC_CMP3;
        HAL_HRTIM_ADCTriggerConfig(&hhrtim1, HRTIM_ADCTRIGGER_1, &adc_trigger_config);
        PrevActivePhases = 3;
        break;

      case 4: /* 4 FASI ATTIVE: PH1, PH2, PH3, PH4 sfasate di 90° (MULTIPHASE_PERIOD / 4) */
      default:
        NumActivePhases = 4; /* Se scrivi per sbaglio un numero fuori range, forza 4 fasi */
        /* Sfasamento PH2 a 90°, PH3 a 180°, PH4 a 270° */
        __HAL_HRTIM_SETCOMPARE(&hhrtim1, HRTIM_TIMERINDEX_MASTER, HRTIM_COMPAREUNIT_1, (MULTIPHASE_PERIOD / 4));
        __HAL_HRTIM_SETCOMPARE(&hhrtim1, HRTIM_TIMERINDEX_MASTER, HRTIM_COMPAREUNIT_2, 2 * (MULTIPHASE_PERIOD / 4));
        __HAL_HRTIM_SETCOMPARE(&hhrtim1, HRTIM_TIMERINDEX_MASTER, HRTIM_COMPAREUNIT_3, 3 * (MULTIPHASE_PERIOD / 4));

        /* Abilita tutte e 4 le uscite */
        HAL_HRTIM_WaveformOutputStart(&hhrtim1, HRTIM_OUTPUT_TA1 | HRTIM_OUTPUT_TB1 | HRTIM_OUTPUT_TC1 | HRTIM_OUTPUT_TD1);

        /* Trigger ADC: 4 reali (TA_CMP2, TB_CMP2, TC_CMP2, TD_CMP3) */
        adc_trigger_config.Trigger = HRTIM_ADCTRIGGEREVENT13_TIMERA_CMP2
                                   | HRTIM_ADCTRIGGEREVENT13_TIMERB_CMP2
                                   | HRTIM_ADCTRIGGEREVENT13_TIMERC_CMP2
                                   | HRTIM_ADCTRIGGEREVENT13_TIMERD_CMP3;
        HAL_HRTIM_ADCTriggerConfig(&hhrtim1, HRTIM_ADCTRIGGER_1, &adc_trigger_config);
        PrevActivePhases = 4;
        break;
    }
  }
}

/* Callback chiamata in automatico ogni volta che premi un tasto sulla tastiera */
void HAL_UART_RxCpltCallback(UART_HandleTypeDef *huart)
{
  if (huart->Instance == USART2)
  {
    /* Se l'utente ha premuto INVIO (\r o \n) */
    if (uart_rx_byte == '\r' || uart_rx_byte == '\n')
    {
      if (uart_rx_index > 0) /* Se c'è almeno un carattere scritto */
      {
        uart_rx_buffer[uart_rx_index] = '\0'; /* Chiudi la stringa */
        char msg_out[64];

        /* Controlla se l'utente vuole cambiare il numero di fasi (es. "P2" o "p2") */
        if (uart_rx_buffer[0] == 'P' || uart_rx_buffer[0] == 'p')
        {
          int phases = atoi(&uart_rx_buffer[1]);
          if (phases >= 1 && phases <= 4)
          {
            NumActivePhases = (uint8_t)phases;
            snprintf(msg_out, sizeof(msg_out), "\r\n-> Fasi attive impostate a: %d\r\n", NumActivePhases);
            HAL_UART_Transmit(&huart2, (uint8_t*)msg_out, strlen(msg_out), 50);
          }
        }
        else
        {
          /* Altrimenti interpreta l'input come Duty Cycle (da 1 a 100%) */
          float val = atof(uart_rx_buffer);
          if (val >= 1.0f && val <= 100.0f)
          {
            TargetDutyPercent = val;
            snprintf(msg_out, sizeof(msg_out), "\r\n-> Nuovo Duty Cycle: %d%%\r\n", (int)TargetDutyPercent);
            HAL_UART_Transmit(&huart2, (uint8_t*)msg_out, strlen(msg_out), 50);
          }
          else
          {
            char err_msg[] = "\r\nErrore: inserisci un valore tra 1 e 100!\r\n";
            HAL_UART_Transmit(&huart2, (uint8_t*)err_msg, strlen(err_msg), 50);
          }
        }
        uart_rx_index = 0; /* Azzera il buffer per il prossimo comando */
      }
    }
    else
    {
      /* Rimanda il carattere a schermo (Echo) così vedi cosa stai digitando */
      HAL_UART_Transmit(&huart2, &uart_rx_byte, 1, 10);

      /* Salva il carattere nel buffer se c'è spazio */
      if (uart_rx_index < sizeof(uart_rx_buffer) - 1)
      {
        uart_rx_buffer[uart_rx_index++] = (char)uart_rx_byte;
      }
    }

    /* Ri-attiva subito l'ascolto per il prossimo tasto premuto */
    HAL_UART_Receive_IT(&huart2, &uart_rx_byte, 1);
  }
}
/* USER CODE END 4 */
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
