davidectnia/InterleavedBoost-LIGH2TDRONE/STM32/IBC_Tesi_4phases_CL_fixedpoint/Core/Inc/ntc_lut.h

#ifndef NTC_LUT_H
#define NTC_LUT_H

#include <stdint.h>

/* LUT generated for  Vishay NTCALUG01T: R25=10000, Beta=3984, R_pullup=10000 */
const int16_t NTC_TEMP_LUT[4096] = {
    -400, 1500, 1500, 1500, 1500, 1500, 1500, 1500, 1500, 1500, 1500, 1500, 1500, 1500, 1500, 1500, 
    1500, 1500, 1500, 1500, 1500, 1500, 1500, 1500, 1500, 1500, 1500, 1500, 1500, 1500, 1500, 1500, 
    1500, 1500, 1500, 1500, 1500, 1500, 1500, 1500, 1500, 1500, 1500, 1500, 1500, 1500, 1500, 1500, 
    1500, 1500, 1500, 1500, 1500, 1500, 1500, 1500, 1500, 1500, 1500, 1500, 1500, 1500, 1500, 1500, 
    1500, 1500, 1500, 1500, 1500, 1500, 1500, 1500, 1500, 1500, 1500, 1500, 1500, 1500, 1497, 1492, 
    1486, 1480, 1475, 1469, 1464, 1458, 1453, 1448, 1443, 1438, 1433, 1428, 1423, 1418, 1414, 1409, 
    1404, 1400, 1395, 1391, 1386, 1382, 1378, 1374, 1369, 1365, 1361, 1357, 1353, 1349, 1345, 1341, 
    1337, 1334, 1330, 1326, 1323, 1319, 1315, 1312, 1308, 1305, 1301, 1298, 1294, 1291, 1288, 1284, 
    1281, 1278, 1275, 1271, 1268, 1265, 1262, 1259, 1256, 1253, 1250, 1247, 1244, 1241, 1238, 1235, 
    1232, 1230, 1227, 1224, 1221, 1219, 1216, 1213, 1210, 1208, 1205, 1203, 1200, 1197, 1195, 1192, 
    1190, 1187, 1185, 1182, 1180, 1177, 1175, 1173, 1170, 1168, 1166, 1163, 1161, 1159, 1156, 1154, 
    1152, 1150, 1147, 1145, 1143, 1141, 1139, 1136, 1134, 1132, 1130, 1128, 1126, 1124, 1122, 1120, 
    1118, 1116, 1114, 1112, 1110, 1108, 1106, 1104, 1102, 1100, 1098, 1096, 1094, 1092, 1090, 1088, 
    1087, 1085, 1083, 1081, 1079, 1077, 1076, 1074, 1072, 1070, 1069, 1067, 1065, 1063, 1062, 1060, 
    1058, 1056, 1055, 1053, 1051, 1050, 1048, 1046, 1045, 1043, 1042, 1040, 1038, 1037, 1035, 1034, 
    1032, 1030, 1029, 1027, 1026, 1024, 1023, 1021, 1020, 1018, 1017, 1015, 1014, 1012, 1011, 1009, 
    1008, 1006, 1005, 1003, 1002, 1000, 999, 998, 996, 995, 993, 992, 991, 989, 988, 986, 
    985, 984, 982, 981, 980, 978, 977, 976, 974, 973, 972, 970, 969, 968, 967, 965, 
    964, 963, 961, 960, 959, 958, 956, 955, 954, 953, 951, 950, 949, 948, 947, 945, 
    944, 943, 942, 941, 939, 938, 937, 936, 935, 933, 932, 931, 930, 929, 928, 927, 
    925, 924, 923, 922, 921, 920, 919, 917, 916, 915, 914, 913, 912, 911, 910, 909, 
    908, 907, 906, 904, 903, 902, 901, 900, 899, 898, 897, 896, 895, 894, 893, 892, 
    891, 890, 889, 888, 887, 886, 885, 884, 883, 882, 881, 880, 879, 878, 877, 876, 
    875, 874, 873, 872, 871, 870, 869, 868, 867, 866, 865, 864, 863, 862, 862, 861, 
    860, 859, 858, 857, 856, 855, 854, 853, 852, 851, 850, 850, 849, 848, 847, 846, 
    845, 844, 843, 842, 842, 841, 840, 839, 838, 837, 836, 835, 835, 834, 833, 832, 
    831, 830, 829, 829, 828, 827, 826, 825, 824, 824, 823, 822, 821, 820, 819, 819, 
    818, 817, 816, 815, 815, 814, 813, 812, 811, 811, 810, 809, 808, 807, 807, 806, 
    805, 804, 803, 803, 802, 801, 800, 799, 799, 798, 797, 796, 796, 795, 794, 793, 
    793, 792, 791, 790, 790, 789, 788, 787, 787, 786, 785, 784, 784, 783, 782, 781, 
    781, 780, 779, 779, 778, 777, 776, 776, 775, 774, 773, 773, 772, 771, 771, 770, 
    769, 768, 768, 767, 766, 766, 765, 764, 764, 763, 762, 762, 761, 760, 759, 759, 
    758, 757, 757, 756, 755, 755, 754, 753, 753, 752, 751, 751, 750, 749, 749, 748, 
    747, 747, 746, 745, 745, 744, 743, 743, 742, 741, 741, 740, 740, 739, 738, 738, 
    737, 736, 736, 735, 734, 734, 733, 733, 732, 731, 731, 730, 729, 729, 728, 727, 
    727, 726, 726, 725, 724, 724, 723, 723, 722, 721, 721, 720, 720, 719, 718, 718, 
    717, 716, 716, 715, 715, 714, 713, 713, 712, 712, 711, 711, 710, 709, 709, 708, 
    708, 707, 706, 706, 705, 705, 704, 703, 703, 702, 702, 701, 701, 700, 699, 699, 
    698, 698, 697, 697, 696, 695, 695, 694, 694, 693, 693, 692, 692, 691, 690, 690, 
    689, 689, 688, 688, 687, 687, 686, 685, 685, 684, 684, 683, 683, 682, 682, 681, 
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
};

#endif /* NTC_LUT_H */
