davidectnia/InterleavedBoost-LIGH2TDRONE/STM32/IBC_Tesi_4phases_CL/Core/Inc/power_stage.h

/*
 * power_stage.h
 *
 *  Created on: Nov 4, 2026
 *      Author: Davide Catania
 */

#ifndef POWER_STAGE_H_
#define POWER_STAGE_H_

#include <stdint.h>

void PowerStage_UpdatePhases(uint8_t active_phases);
void PowerStage_ApplyDutyCycles(volatile float *duty_array);
void PowerStage_EmergencyStop(void);

#endif /* INC_POWER_STAGE_H_ */
