davidectnia/InterleavedBoost-LIGH2TDRONE/(notices)

Notices in the files:
STM32/IBC_Tesi_4phases_CL_fixedpoint/Core/Src/main_corrected.c:
Copyright (c) 2026 STMicroelectronics.
All rights reserved.
This software is licensed under terms that can be found in the LICENSE file
